ivvalachaitanya/Ender3_auto_cutter_plotter/assets/snapshots/camera_snapshot_1789722992.jpg

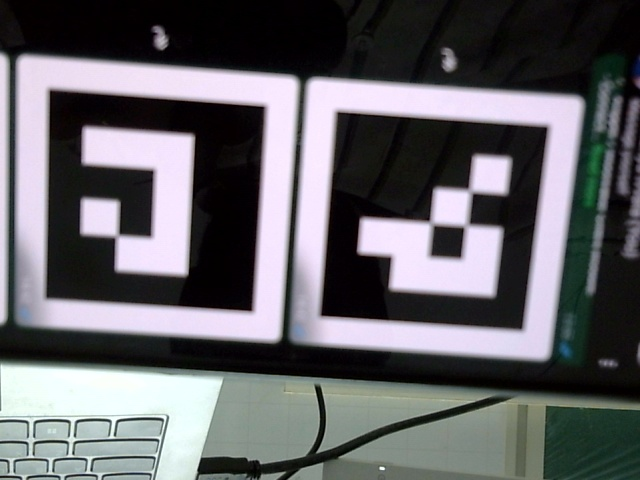
assets/snapshots/camera_snapshot_1789722992.jpg
