ivvalachaitanya/Ender3_auto_cutter_plotter/assets/images/c270_mount_views.png

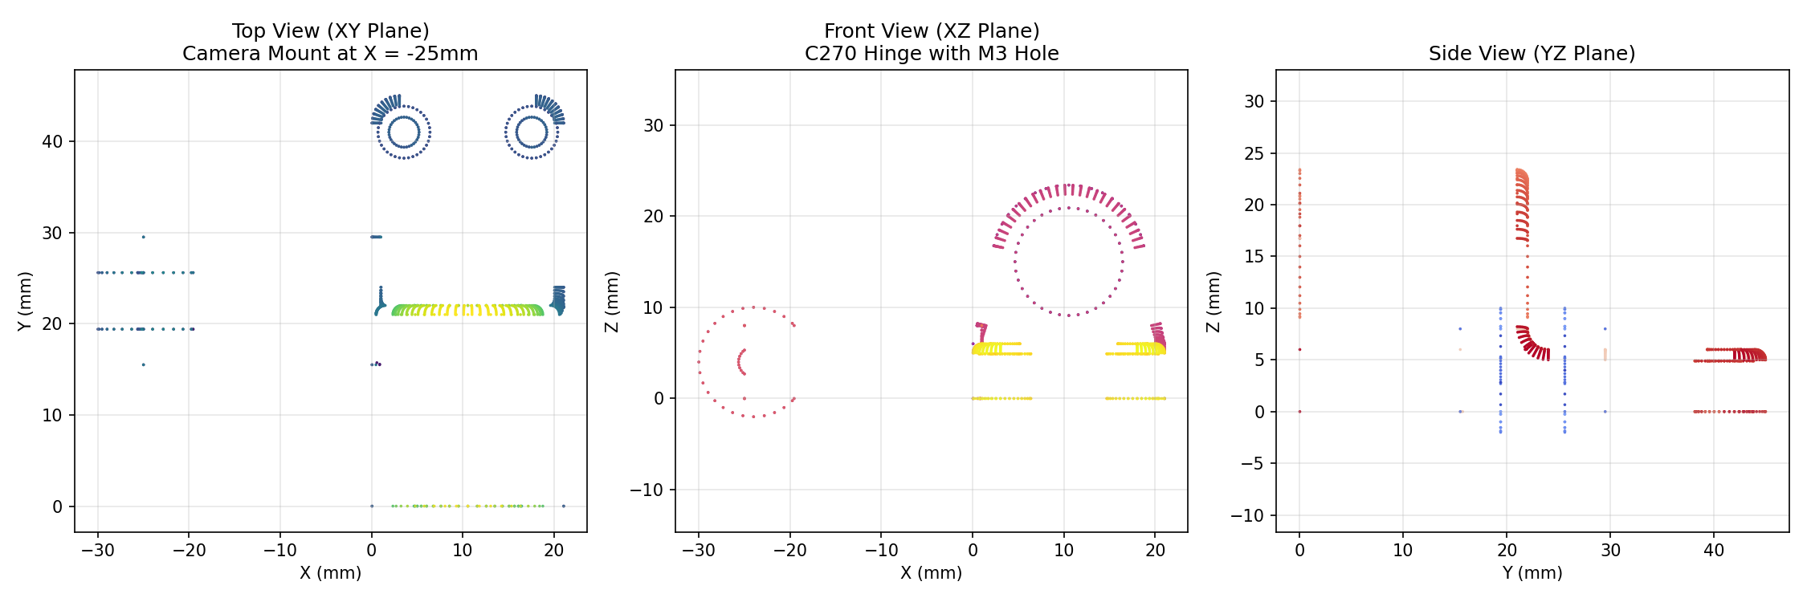
assets/images/c270_mount_views.png
