ivvalachaitanya/Ender3_auto_cutter_plotter/assets/images/supporto_views.png

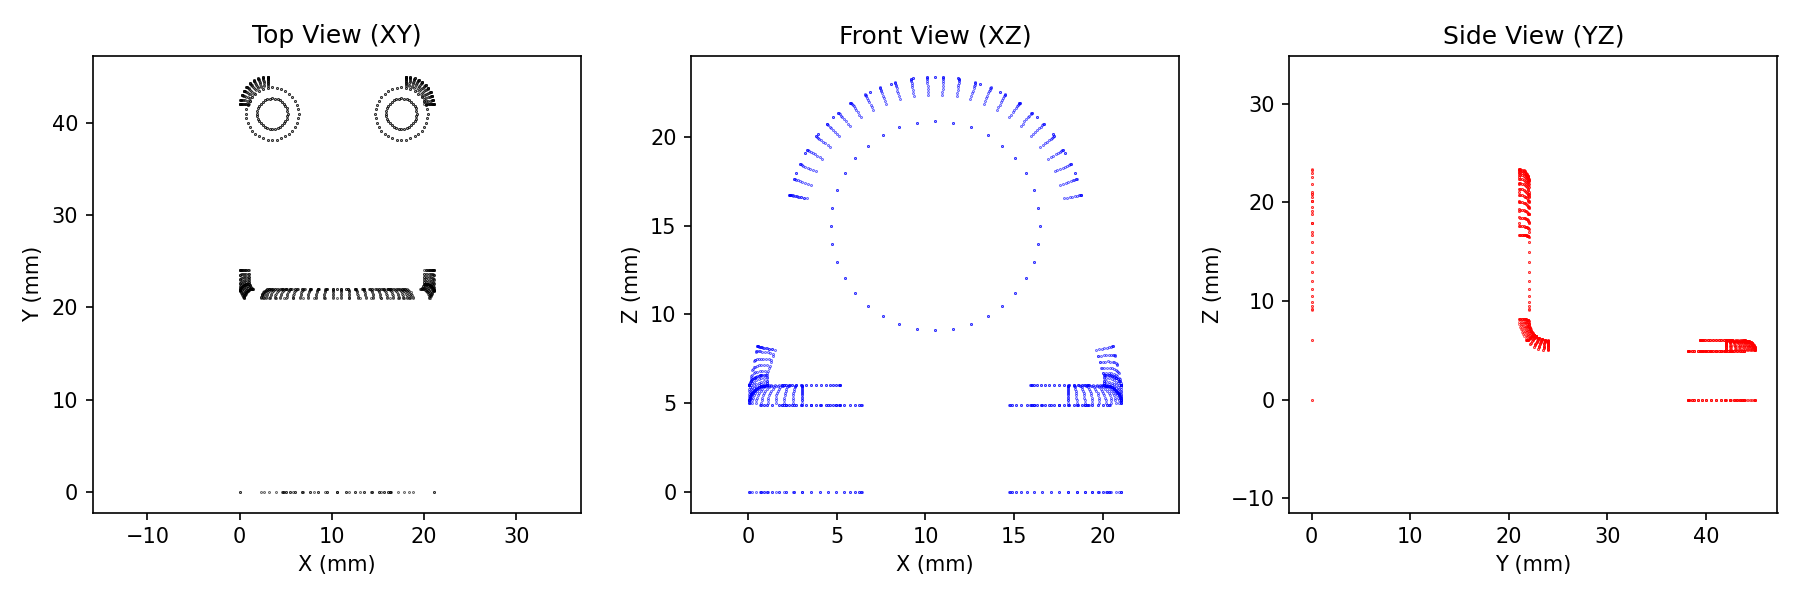
assets/images/supporto_views.png
