ivvalachaitanya/Ender3_auto_cutter_plotter/assets/snapshots/snapshot_coords_1789723641.jpg

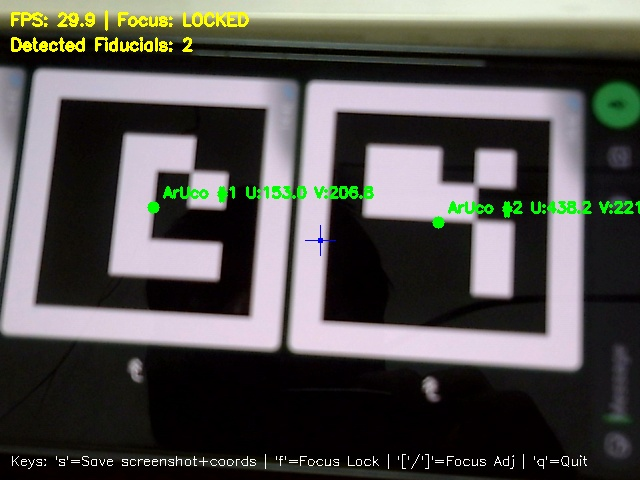
assets/snapshots/snapshot_coords_1789723641.jpg
