ivvalachaitanya/Ender3_auto_cutter_plotter/mechanical/Logitech C270 Focus inner.stl

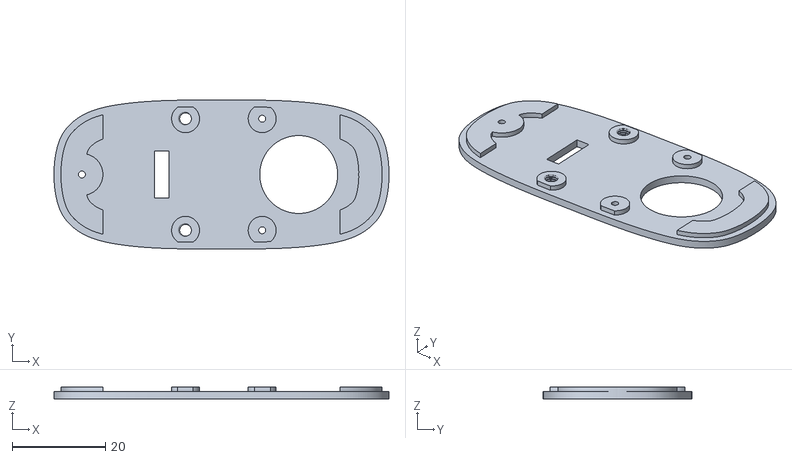
[picture p9: CAD file, 2026-09-24]
mechanical/Logitech C270 Focus inner.stl
72.0 x 32.0 x 2.60
