ivvalachaitanya/Ender3_auto_cutter_plotter/SupportoDragKnife_with_C270_CameraMount.stl

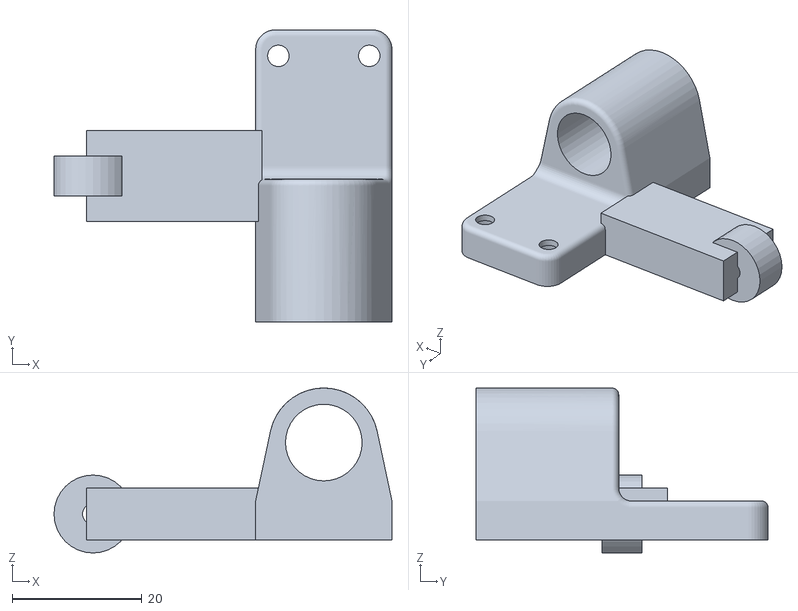
[picture p10: CAD file, 2026-09-21]
SupportoDragKnife_with_C270_CameraMount.stl
52.0 x 45.0 x 25.4
