ivvalachaitanya/Ender3_auto_cutter_plotter/mechanical/SupportoDragKnife.SLDPRT

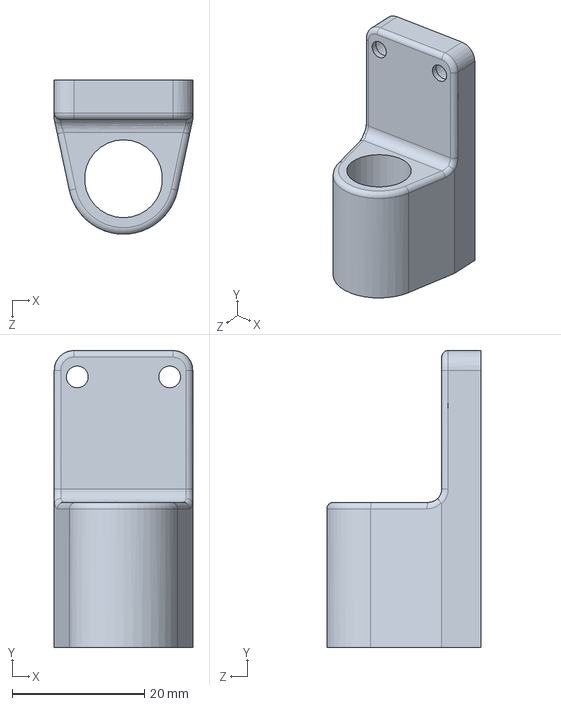
[picture p11: CAD file, 2026-09-24]
mechanical/SupportoDragKnife.SLDPRT
21.0 x 45.0 x 23.4 mm
