ivvalachaitanya/Ender3_auto_cutter_plotter/mechanical/LogiC270_wheel.stl

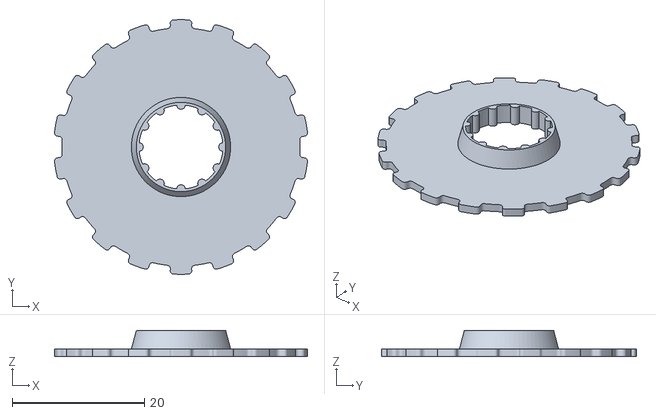
[picture p13: CAD file, 2026-09-24]
mechanical/LogiC270_wheel.stl
38.3 x 38.5 x 4.00
