ivvalachaitanya/Ender3_auto_cutter_plotter/mechanical/Ender3VinylCutter.3mf

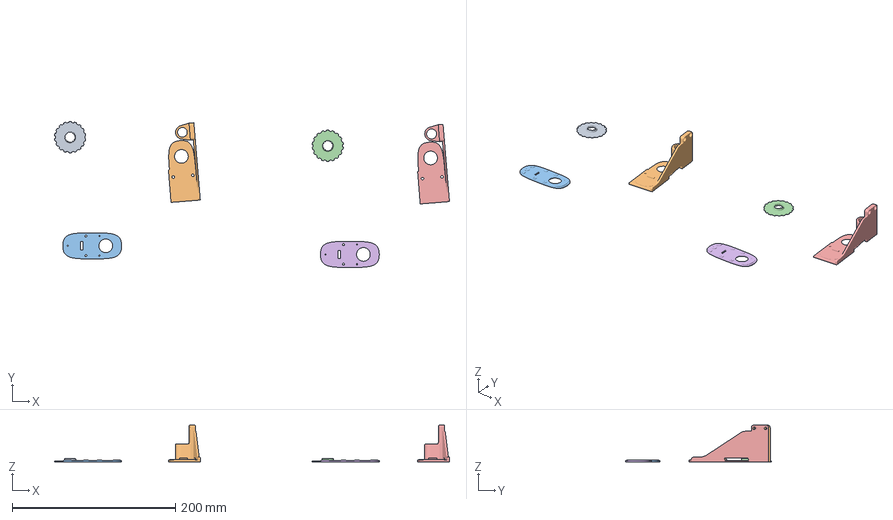
[picture p14: CAD file, 2026-09-24]
mechanical/Ender3VinylCutter.3mf
483.8 x 178.8 x 45.1 mm
LogiC270_wheel.stl x 2
ender3vinylcutter.stl x 2
Logitech C270 Focus inner.stl x 2
