ivvalachaitanya/Ender3_auto_cutter_plotter/(list of files, cad)

Other CAD files:
mechanical/SupportoDragKnife.STL
mechanical/ender3vinylcutter.stl
