ivvalachaitanya/Ender3_auto_cutter_plotter/(commit log)

2026-09-18 Add complete computer-vision print and cut vinyl cutting pipeline
2026-09-18 Pin numpy<2.0.0 in requirements.txt for OpenCV compatibility
2026-09-18 Add camera focus controls and screenshot capture with pixel coordinate JSON metadata
2026-09-18 Add live image sharpness meter and distance advice to camera test script
2026-09-18 Support detecting and rendering all circular fiducials visible in camera frame
2026-09-18 Fix SVG Y-axis inversion to match 3D printer bottom-left origin coordinate system
2026-09-18 Fix Inkscape px-to-mm scaling (25.4/96) and Y-axis origin inversion
2026-09-19 Add /print-artwork popup to print raw 1:1 SVG artwork on color printer
2026-09-19 Document automatic routing of color artwork to 2D paper printer vs vector paths to Ender cutter
2026-09-19 Ensure /print-artwork uses full color artwork Cut.svg for printing
2026-09-19 Render full color sticker artwork with red cut path outlines together in preview and print window
2026-09-21 add live camera feed window, MJPEG stream, and camera selection dropdown
2026-09-21 add Hardware Settings modal, bed size, blade offset, camera offsets, and config.json persistence
2026-09-21 update SVG preview canvas to display bed dimensions and match bed aspect ratio dynamically
2026-09-21 render physical bed cutting mat with grid background and crop printable paper working area to bed scale
2026-09-21 fix preview to maintain true 1:1 physical aspect ratio without squishing sheet height, adding red hazard overlay for bed limit overrun
2026-09-21 add Dual Alignment Mode (Auto ArUco vs Manual Camera Jog Crosshair Alignment) with D-Pad controls and manual point locking
2026-09-21 add Logitech C270 camera mount extension to SupportoDragKnife.STL with parametric python generator
2026-09-24 Organize repository structure into mechanical, scripts, samples, and assets directories, update README.md and .gitignore
2026-09-24 Add Trace Bounding Box (Frame) feature to Web GUI and backend API
2026-09-28 Update web_gui and config for persistent Moonraker connection and add sample PolyCut file
2026-09-28 feat: add Save G-code button and CLI support for z-lift-swivel
2026-09-28 fix: connect real Crowsnest camera stream and remove forced mock mode on scan
2026-09-28 fix: target gantry coordinate offset calculation and non-negative bounds clamping
2026-09-29 feat: add BED_MESH_PROFILE LOAD=default to G-code header for real-time Klipper bed warp compensation
2026-09-29 feat: add Bed Mesh Z-Cut Test Pattern Generator modal and API endpoint to Web UI
2026-09-30 feat: add 4-Corner Bed Leveling (Tramming) Helper buttons to Web UI Step 3
2026-09-30 fix: set camera_offset_x_mm to +25 for camera mounted right of knife tip
2026-09-30 feat: add pause_before_cut support to GCodeGenerator using Klipper PAUSE and RESPOND
2026-10-27 fix: increase G28 homing timeout to 60s and web UI scan timeout to 180s to prevent early abort
2026-10-27 fix: skip redundant G28 homing when homed and fix camera fiducial jog target calculation
2026-10-27 fix: default camera stream to Klipper Crowsnest and safely catch USB camera open exceptions
2026-10-27 fix: calibrate camera scanning focal height to Z=20mm with M400 move settlement
2026-10-27 feat: autonomous fiducial search with rigid geometric projection and visual servoing
2026-10-27 feat: add multi-tier search speed preferences with auto-cascade and fast MJPEG frame extraction
2026-10-27 feat: add animated button loading states and visual progress feedback to Cutter Studio UI
2026-10-29 fix: fast MJPEG delimiter stream, non-blocking camera enum, safe UI selection, and standalone start_cutter_studio.bat
2026-10-29 fix(gui): resolve python environment conflicts, remove blocking CDN, throttle streamer ArUco detection
2026-10-29 fix(gui): fix fatal syntax error in addLog split to restore all button handlers and pipeline logs
2026-10-29 fix: calibrate camera offsets to 19.0mm X and -1.0mm Y based on test cut
2026-10-29 feat: add quick Cut Z Depth control to Step 4 card and API handlers
2026-10-31 Add UI button and backend endpoint to inject ArUco fiducials into SVG
2026-10-31 fix: pass design fiducials to extract_touch_dots to resolve 15-19mm verification offset
2026-10-31 feat: add assisted alignment mode with paper adjustment pause and 2.0s camera feed stabilization dwell
2026-10-31 feat: live-recalculate affine matrix on camera offset settings change and sync verify_touch_dots
2026-10-31 fix: lift blade to safe height (>=5mm) before Klipper PAUSE to prevent paper dragging
2026-10-31 feat: add RESUME_BASE support and Cutter Studio resume button to bypass cold extruder check
2026-11-02 feat: add early error trap in head, unhandled rejection listener, and copy log button
2026-11-03 fix: make G-code generation and alignment safe for real cuts
    G-code generation
    - Safe travel and lift-and-turn heights are now relative to z_cut
    (safe_travel_z keeps travel >= 5 mm above the cut plane). Previously
    a lift height below z_cut drove the blade into the bed.
    - SVG parser cuts each subpath separately (no cut stroke between
    subpaths of compound paths / letters) and accepts rect, circle,
    ellipse, line, polyline and polygon instead of dropping them.
    - Closed-path overcut follows the start of the contour instead of a
    straight line along the last segment; overcut is configurable
    (--overcut, overcut_mm, Settings modal). Added --pause-before-cut.
    G-code transformer (PolyCut/J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
2026-11-03 chore: commit remaining workspace changes
    - src/__init__.py: export package API
    - moonraker_client: persistent local OpenCV capture with one reopen retry
    - vision_detector: use real camera frame size instead of hardcoded 640x480
    - config.json: design fiducials moved to Y=195
    - scripts: camera mount generator and PC camera test tweaks
    - add sample/design SVGs and generated cutter G-code
2026-11-03 feat: PolyCut-style cut path pipeline with blade-aware ordering
    Path conversion (src/drag_knife_planner.py)
    - Flatten SVG per segment: straight edges keep exact corners (a 20x15
    rect is now 4 corners, was 143 points with corners shaved 0.18 mm),
    curves are subdivided adaptively to 0.01 mm.
    - optimize_cut_order: inside-first (holes and inner details before the
    outline that frees them), nearest-neighbour, closed shapes start on a
    smooth point or mid-edge (never a corner), may run either direction,
    open paths may be reversed; start direction is chosen to match the
    blade's current heading.
    - Entry swivel: the planner tracks the blade heading across contours, so
    the tip lands on the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
2026-11-03 feat: rebuild registration-mark search (FOV-sized steps, rotation from marker, reach-aware)
    Why the old search missed marks:
    - The camera sees only 18.8 x 14.1 mm and an ArUco mark decodes only when
    its 7.9 mm black square is fully in view (centre within +/-5.4 x +/-3.1
    mm), but the spiral stepped 14 mm in X and Y, leaving ~2/3 unseen.
    - Marks #2/#3 (170-180 mm away) were predicted assuming a square sheet;
    ~1.5 deg of skew moved them out of view.
    - Assisted mode parked at the last gantry spot (X=0), the camera's reach
    limit (it sits 29.6 mm right of the knife), so a skewed sheet put the
    lower-left mark where no search can see it.
    - "Exhaustive" probed 14 fixed points.
    New search (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
2026-11-03 fix: write swivel arcs as G1 segments by default
    The printer has no [gcode_arcs] section, so every G2/G3 swivel would
    abort the cut with "Unknown command". Swivels are now written as short
    G1 chords within 0.005 mm of the arc (5 moves for a 90 deg swivel at
    0.35 mm blade offset). G2/G3 stay available via use_gcode_arcs /
    --gcode-arcs, with an automatic fallback when the printer lacks
    [gcode_arcs].
2026-11-03 feat: Camera Accuracy Check button (visual alignment check, no blade contact)
    New Step 4 button next to the Touch-Off Test. The camera visits the three
    printed touch dots at their aligned positions, finds each target's
    centre (Hough ring + centroid of the filled centre dot, sub-pixel;
    a known 30x20 px shift measured as 30.00x19.99 px) and reports the
    error in mm per dot, max and RMS, with a verdict (excellent <=0.15 mm,
    good <=0.3, fair <=0.6, poor). A modal shows each annotated camera view:
    green cross = expected position, red circle = detected target, 1 mm
    scale bar.
    First run on the printer: max 0.10 mm, RMS 0.08 mm (Excellent).
    Also: touch-dot bed positions are computed by one helper
    (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
2026-11-03 chore: store printer calibration from first live scan
    mm_per_pixel 0.0293 -> 0.0301 (measured from the ArUco marks at the
    image centre), camera_rotation_deg learned from the scan, and
    nominal_fiducials updated to the latest mark positions.
2026-11-03 feat: scripts/measure_bed_corners.py for bed levelling with the BLTouch
    Clears the mesh, probes as close to each [bed_screws] position as the
    probe can reach, fits a plane, and prints how far (and ~how many M4
    turns) to lower each corner. Re-run after each knob adjustment.
2026-11-03 feat: configurable Klipper bed mesh profile for cuts; use the new "cutter" mesh
    The cut G-code loaded BED_MESH_PROFILE LOAD=default unconditionally, and
    that profile was stale (bed had moved; up to 1.4 mm off). The profile is
    now a setting (bed_mesh_profile, --mesh-profile, Settings modal), and
    config.json points at "cutter": a cold, bare-bed 7x7 mesh taken after
    levelling (range 0.29 mm, was 2.24 mm before levelling).
2026-11-03 docs: add docs/ folder and rewrite README
    New docs/ pages: workflow, configuration (config.json keys, CLI flags,
    printer.cfg), calibration, bed levelling, registration-mark search,
    cut-path pipeline, alignment & safety rules, testing (simulators, live
    results, hardware checklist) and a changelog for this branch.
    README rewritten: current features and calibration values, accurate
    repository layout, quick start for GUI/CLI/bed levelling, links to every
    docs page. Removed outdated content (mm_per_pixel 0.05, camera offset
    -25, 220 mm bed, [gcode_arcs] required, absolute file:// link) and the
    reversed camera-offset formula.
2026-11-03 chore: remove unused SupportoDragKnife_with_C270_CameraMount.stl
    The knife bracket and the full toolhead assembly (Ender3VinylCutter.3mf)
    remain; README updated to match.
